Brady-Beecham/Capstone-Team-PowerHouse/Documentation/Electrical/PCB/LT4020_12_BatCharger/LT4020_12_BatCharger.kicad_pcb

## KiCad design Documentation/Electrical/PCB/LT4020_12_BatCharger/LT4020_12_BatCharger.kicad_pcb (2024-04-29)

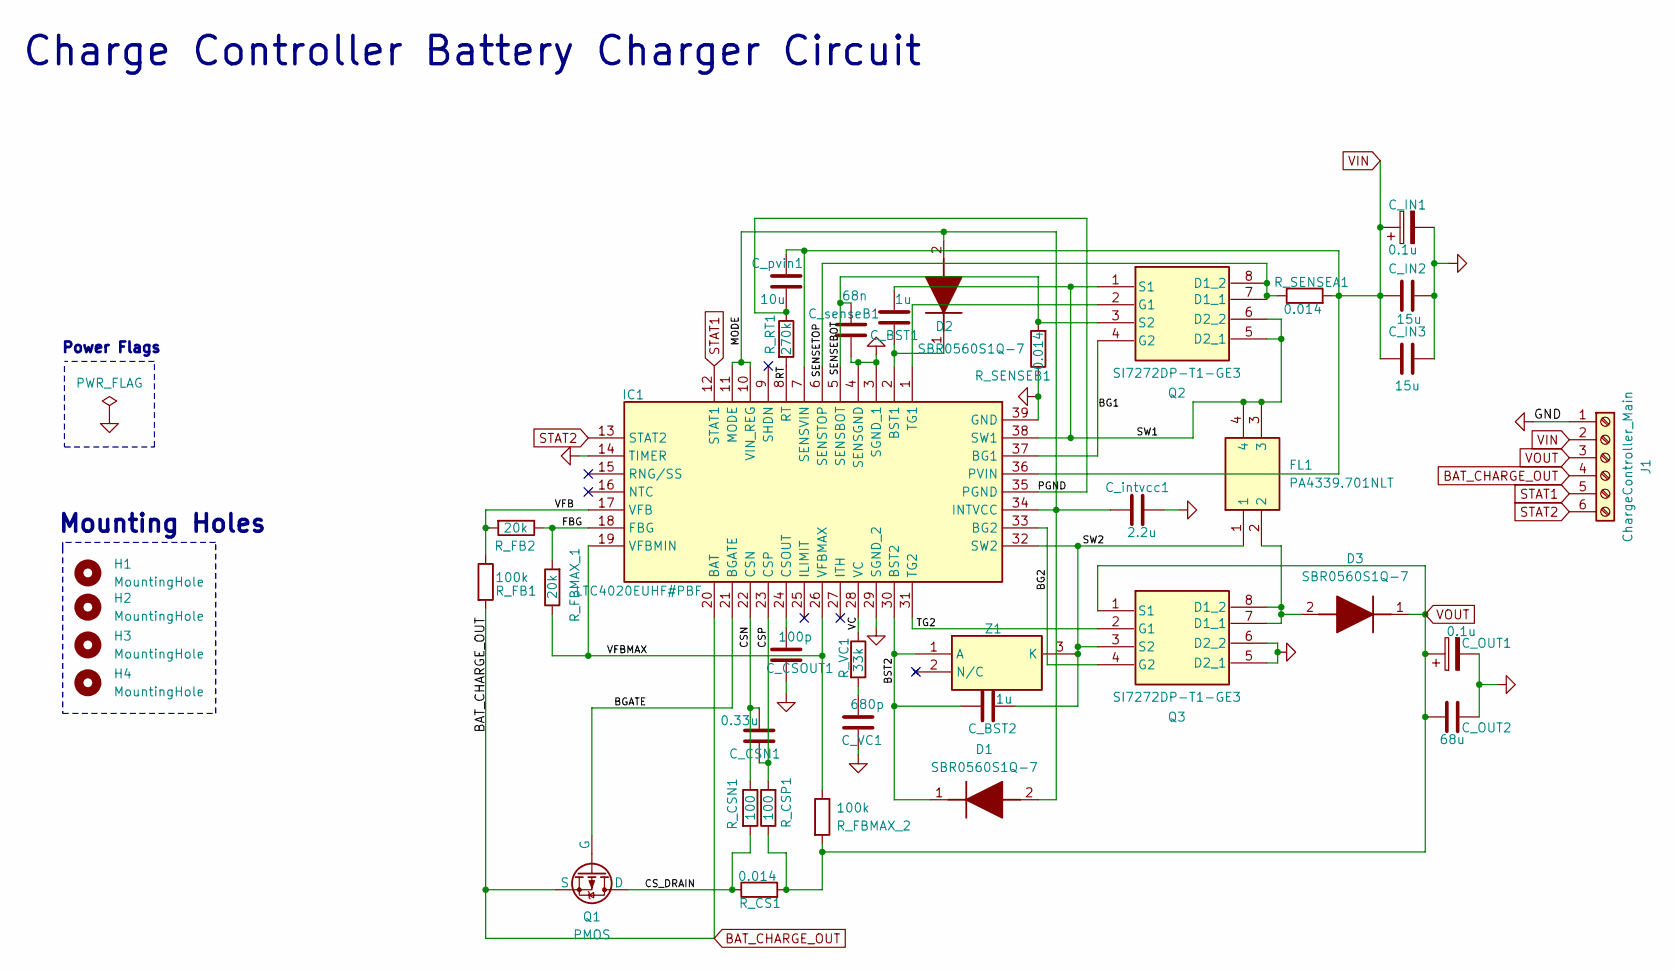
[picture p1: schematic LT4020_12_BatCharger.kicad_sch, 12 V Sealed Lead Acid Battery Charger w/ 12 V Input]

Parts:
C_BST1, C_BST2: 1u; C_1206_3216Metric_Pad1.33x1.80mm_HandSolder
C_CSN1: 0.33u; C_1206_3216Metric_Pad1.33x1.80mm_HandSolder
C_CSOUT1: 100p; C_1206_3216Metric_Pad1.33x1.80mm_HandSolder
C_IN1: 0.1u; C_1206_3216Metric_Pad1.33x1.80mm_HandSolder
C_IN2, C_IN3: 15u; C_1206_3216Metric_Pad1.33x1.80mm_HandSolder
C_OUT1: 0.1u; C_1206_3216Metric_Pad1.33x1.80mm_HandSolder
C_OUT2: 68u; C_1206_3216Metric_Pad1.33x1.80mm_HandSolder
C_VC1: 680p; C_1206_3216Metric_Pad1.33x1.80mm_HandSolder
C_intvcc1: 2.2u; C_1206_3216Metric_Pad1.33x1.80mm_HandSolder
C_pvin1: 10u; CAPPRD250W65D630H900
C_senseB1: 68n; C_1206_3216Metric_Pad1.33x1.80mm_HandSolder
D1, D2, D3: SBR0560S1Q-7; SOD3716X145N; Manufacturer_Part_Number SBR0560S1Q-7; Mouser Part Number 621-SBR0560S1Q-7
FL1: PA4339.701NLT; PA4339701NLT; Manufacturer_Part_Number PA4339.701NLT; Mouser Part Number 673-PA4339.701NLT
H1, H2, H3, H4: MountingHole; MountingHole_2.2mm_M2
IC1: LTC4020EUHF#PBF; QFN50P500X700X80-39N-D; Manufacturer_Part_Number LTC4020EUHF#PBF; Mouser Part Number N/A
J1: ChargeController_Main; SolderWire-1sqmm_1x06_P7.8mm_D1.4mm_OD3.9mm
Q1: PMOS; NVD5117PLT4GVF01
Q2, Q3: SI7272DP-T1-GE3; SI7288DPT1GE3; Manufacturer_Part_Number SI7272DP-T1-GE3; Mouser Part Number 781-SI7272DP-GE3
R_CS1: 0.014; R_1206_3216Metric_Pad1.30x1.75mm_HandSolder
R_CSN1: 100; R_1206_3216Metric_Pad1.30x1.75mm_HandSolder
R_CSP1: 100; R_1206_3216Metric_Pad1.30x1.75mm_HandSolder
R_FB1: 100k; R_Axial_DIN0309_L9.0mm_D3.2mm_P5.08mm_Vertical
R_FB2: 20k; R_1206_3216Metric_Pad1.30x1.75mm_HandSolder
R_FBMAX_1: 20k; R_1206_3216Metric_Pad1.30x1.75mm_HandSolder
R_FBMAX_2: 100k; R_Axial_DIN0309_L9.0mm_D3.2mm_P5.08mm_Vertical
R_RT1: 270k; R_1206_3216Metric_Pad1.30x1.75mm_HandSolder
R_SENSEA1: 0.014; R_1206_3216Metric_Pad1.30x1.75mm_HandSolder
R_SENSEB1: 0.014; R_1206_3216Metric_Pad1.30x1.75mm_HandSolder
R_VC1: 33k; R_Axial_DIN0309_L9.0mm_D3.2mm_P5.08mm_Vertical
Z1: BZX84C6V2LT116; SOT95P240X115-3N; Manufacturer_Part_Number BZX84C6V2LT116; Mouser Part Number 755-BZX84C6V2LT116

Connections:
/BG1: IC1.37 (BG1), Q2.4 (G2)
/BG2: IC1.33 (BG2), Q3.4 (G2)
/BGATE: IC1.21 (BGATE), Q1.2 (G)
/BST2: C_BST2.1, D1.1 (K), IC1.30 (BST2), Z1.1 (A)
/CSN: C_CSN1.1, IC1.22 (CSN), R_CSN1.1
/CSP: C_CSN1.2, IC1.23 (CSP), R_CSP1.2
/CS_DRAIN: Q1.1 (D), R_CS1.1, R_CSN1.2
/FBG: IC1.18 (FBG), R_FB2.1, R_FBMAX_1.2
/MODE: C_intvcc1.2, D1.2 (A), D2.2 (A), IC1.10 (VIN_REG), IC1.11 (MODE), IC1.34 (INTVCC)
/PGND: C_pvin1.2, IC1.35 (PGND), R_RT1.1
/RT: IC1.8 (RT), R_RT1.2
/SENSEBOT: C_senseB1.1, IC1.5 (SENSBOT), Q2.3 (S2), R_SENSEB1.2
/SENSETOP: IC1.6 (SENSTOP), Q2.7 (D1_1), Q2.8 (D1_2), Q2.9, Q2.11, R_SENSEA1.1
/SW1: C_BST1.1, FL1.3, FL1.4, IC1.38 (SW1), Q2.1 (S1), Q2.5 (D2_1), Q2.6 (D2_2), Q2.10, Q2.12
/SW2: C_BST2.2, FL1.1, IC1.32 (SW2), Q3.3 (S2), Z1.3 (K)
/TG2: IC1.31 (TG2), Q3.2 (G1)
/VC: IC1.28 (VC), R_VC1.1
/VFB: IC1.17 (VFB), R_FB1.1, R_FB2.2
/VFBMAX: IC1.19 (VFBMIN), IC1.26 (VFBMAX), R_FBMAX_1.1, R_FBMAX_2.1
BAT_CHARGE_OUT: IC1.20 (BAT), J1.4, Q1.3 (S), R_FB1.2
GND: C_CSOUT1.2, C_IN1.2, C_IN2.2, C_IN3.2, C_OUT1.2, C_OUT2.1, C_VC1.2, C_intvcc1.1, C_senseB1.2, IC1.3 (SGND_1), IC1.4 (SENSGND), IC1.14 (TIMER), IC1.29 (SGND_2), IC1.39 (GND), J1.1, Q3.5 (D2_1), Q3.6 (D2_2), Q3.12, R_SENSEB1.1
unnamed: C_VC1.1, R_VC1.2
unnamed: C_BST1.2, D2.1 (K), IC1.2 (BST1)
unnamed: D3.2 (A), FL1.2, Q3.7 (D1_1), Q3.8 (D1_2), Q3.9, Q3.11
unnamed: C_CSOUT1.1, IC1.24 (CSOUT)
unnamed: IC1.1 (TG1), Q2.2 (G1)
STAT1: IC1.12 (STAT1), J1.5
STAT2: IC1.13 (STAT2), J1.6
VIN: C_IN1.1, C_IN2.1, C_IN3.1, C_pvin1.1, IC1.7 (SENSVIN), IC1.36 (PVIN), J1.2, R_SENSEA1.2
VOUT: C_OUT1.1, C_OUT2.2, D3.1 (K), J1.3, Q3.1 (S1), R_CS1.2, R_CSP1.1, R_FBMAX_2.2

Notes on the sheet:
Power Flags
Charge Controller Battery Charger Circuit
Mounting Holes

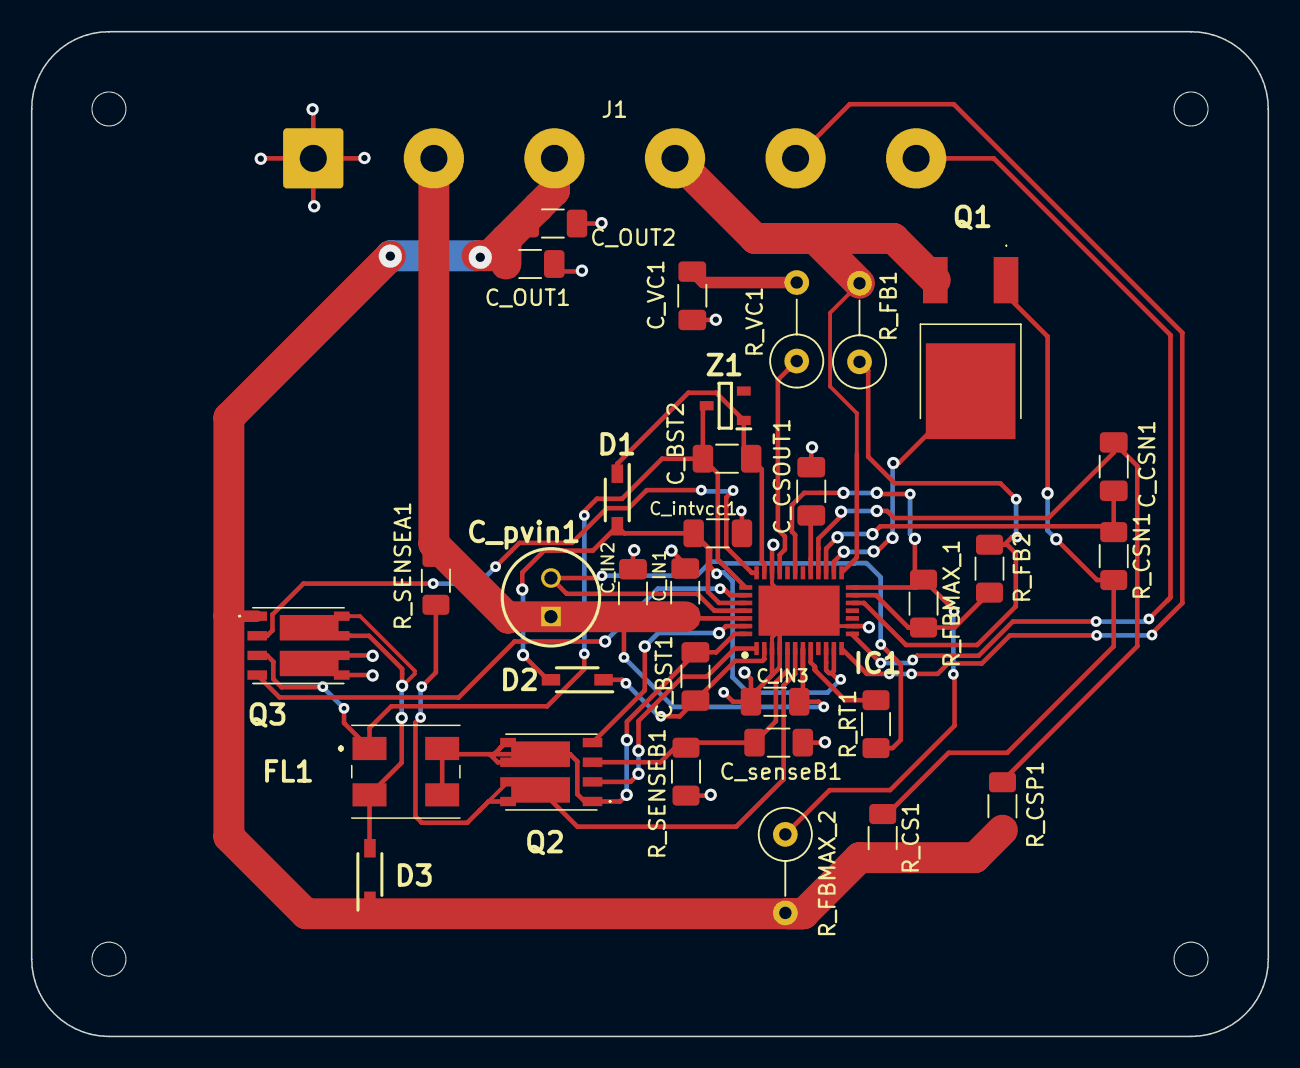
[picture p2: board LT4020_12_BatCharger.kicad_pcb from above]

Board: 2 copper layers, 80.0 x 65.0 mm, 38 parts (0 on the bottom side), 30 nets.
